harshkc03/Kurla-Carshed-Train-Model/README.md

# Mumbai Suburban Railway Signalling System

 * This was made as a part of an internship project at Kurla EMU Carshed during 2019 under guidance of Mr. Nilesh Lohote (SSE, BTC).
 
 * Authors-
    1. [Harsh Chaudhary](https://github.com/harshkc03)
    2. [Khaliluddin Sarkazi](https://github.com/khaliluddin-sarkazi)
    3. [Ayush Misra](https://github.com/ayushcooldude99)
    4. [Shaikh Owais](https://github.com/ar28shaikh)
    
 * Date of completion - 02/01/2020
 
 * Model specifications-
    
    * Arduino MEGA 2560 is used as the controlling unit here
    * One 20x4 LCD display along with push switches are used to make the interface interactive
    * Magnetic NO switches are placed before each signal to determine the location of the train
    * Three coloured signals (Green, Yellow, Red) are used here
    * Two SPDT relays are used to reverse the direction of current in OHE for backward movement of the train. One more SPDT relay is used to start or stop the OHE supply
    * All the 6 interrupts of Arduino MEGA are used in this code
  
  ## Working video- [Link](https://www.youtube.com/watch?v=K29B_VmnoXo)
  
  ## Track Image-
  
  Track Image
  
  ## Train Image-
  
  Train Image
