harshkc03/Kurla-Carshed-Train-Model/PCB Files/Main_PCB_design.pdf

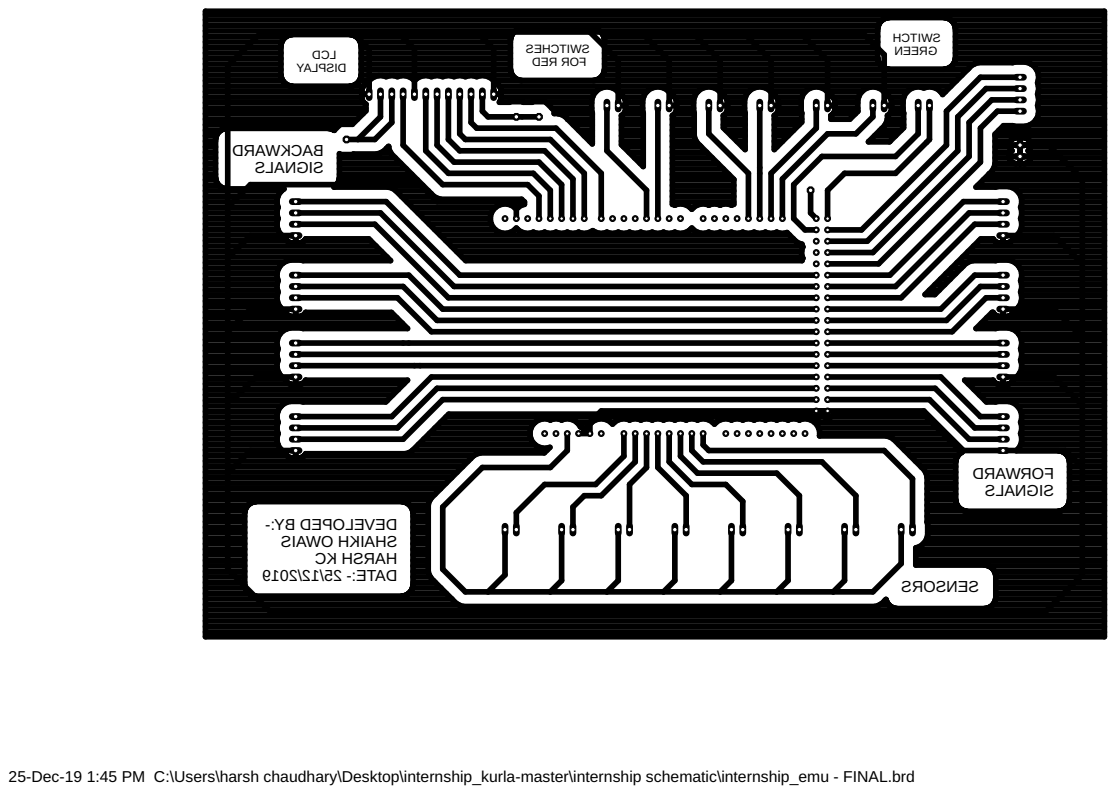
[picture p14: page 1]

SI A WO HKI AHS

25-Dec-19 1:45 PM C:\Users\harsh chaudhary\Desktop\internship_kurla-master\internship schematic\internship_emu - FINAL.brd
