harshkc03/Kurla-Carshed-Train-Model/PCB Files/EAGLE Files/internship_emu.sch

## EAGLE design PCB Files/EAGLE Files/internship_emu.sch (2020-07-11)

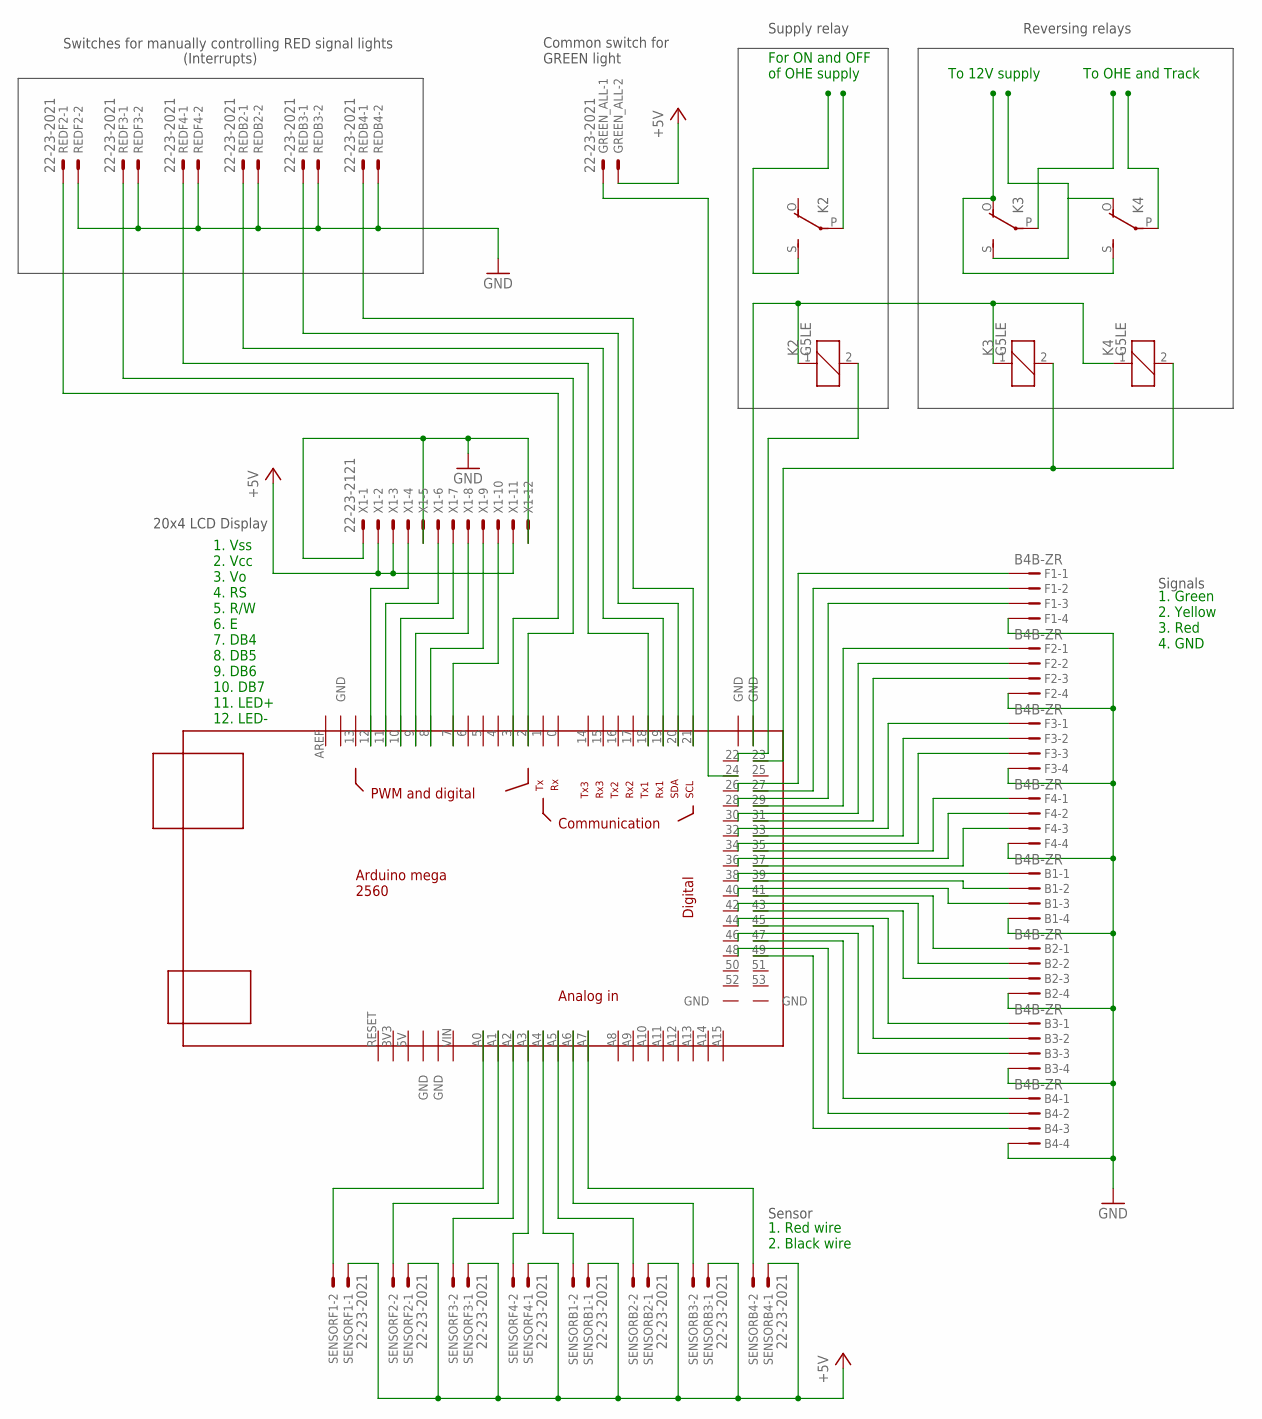
[picture p15: schematic internship_emu.sch]

Parts:
B1, B2, B3, B4: B4B-ZR
F1, F2, F3, F4: B4B-ZR
GREEN_ALL: 22-23-2021
K2, K3, K4: G5LE
REDB2, REDB3, REDB4: 22-23-2021
REDF2, REDF3, REDF4: 22-23-2021
SENSORB1, SENSORB2, SENSORB3, SENSORB4: 22-23-2021
SENSORF1, SENSORF2, SENSORF3, SENSORF4: 22-23-2021
U$1: MEGA_DEVICE; MEGAOUTLINE
X1: 22-23-2121

Connections:
+5V: GREEN_ALL.2, SENSORB1.1, SENSORB2.1, SENSORB3.1, SENSORB4.1, SENSORF1.1, SENSORF2.1, SENSORF3.1, SENSORF4.1, X1.2, X1.3, X1.11
GND: B1.4, B2.4, B3.4, B4.4, F1.4, F2.4, F3.4, F4.4, REDB2.2, REDB3.2, REDB4.2, REDF2.2, REDF3.2, REDF4.2, X1.1, X1.5, X1.12
unnamed: B2.1, U$1.41
unnamed: F1.2, U$1.27
unnamed: F1.3, U$1.28
unnamed: B2.2, U$1.42
unnamed: F2.1, U$1.29
unnamed: F1.1, U$1.26
unnamed: F2.2, U$1.30
unnamed: F2.3, U$1.31
unnamed: F3.1, U$1.32
unnamed: F3.2, U$1.33
unnamed: F3.3, U$1.34
unnamed: F4.1, U$1.35
unnamed: F4.2, U$1.36
unnamed: F4.3, U$1.37
unnamed: B1.1, U$1.38
unnamed: B1.2, U$1.39
unnamed: B1.3, U$1.40
unnamed: B2.3, U$1.43
unnamed: B3.1, U$1.44
unnamed: B3.2, U$1.45
unnamed: B3.3, U$1.46
unnamed: B4.1, U$1.47
unnamed: B4.2, U$1.48
unnamed: B4.3, U$1.49
unnamed: SENSORF1.2, U$1.A0
unnamed: SENSORF2.2, U$1.A1
unnamed: SENSORF3.2, U$1.A2
unnamed: SENSORF4.2, U$1.A3
unnamed: SENSORB1.2, U$1.A4
unnamed: SENSORB2.2, U$1.A5
unnamed: SENSORB3.2, U$1.A6
unnamed: SENSORB4.2, U$1.A7
unnamed: GREEN_ALL.1, U$1.24
unnamed: K2.2, U$1.22
unnamed: K3.2, K4.2, U$1.23
unnamed: U$1.12, X1.4
unnamed: U$1.11, X1.6
unnamed: U$1.10, X1.7
unnamed: U$1.9, X1.8
unnamed: U$1.8, X1.9
unnamed: U$1.7, X1.10
unnamed: K2.1, K3.1, K4.1, U$1.GND@5 (GND)
unnamed: K3.S, K4.O
unnamed: K3.O, K4.S
unnamed: REDF4.1, U$1.18
unnamed: REDF2.1, U$1.3
unnamed: REDF3.1, U$1.2
unnamed: REDB2.1, U$1.19
unnamed: REDB3.1, U$1.20
unnamed: REDB4.1, U$1.21

Notes on the sheet:
1. Green 2. Yellow 3. Red 4. GND
1. Vss 2. Vcc 3. Vo 4. RS 5. R/W 6. E 7. DB4 8. DB5 9. DB6 10. DB7 11. LED+ 12. LED-
1. Red wire 2. Black wire
For ON and OFF of OHE supply
To OHE and Track
To 12V supply
Reversing relays
Sensor
Signals
20x4 LCD Display
Supply relay
Switches for manually controlling RED signal lights
Common switch for GREEN light
(Interrupts)
